user-0021/BLDC_MOTOR_DRIVER_ALPHA/README.md

# BLDC_MOTER_DRIVER_ALPHA
この回路は15~30Vほどの電源で回す三層モータードライバー向けの回路です
設計上の連続最大電流は10Aです(実験してないのでだめかも)
ヒートシンクとかで冷やしながらならFET的には35A行ける
## インターフェース
制御用のインターフェースはLVDSとなっております。
## 機能
ゲートドライバーに過電圧過電流などの保護があります  
ホールセンサの入力はアナログ入力になっているのでプログラムを書けばどのセンサタイプでも  
いけるはず
