user-0021/BLDC_MOTOR_DRIVER_ALPHA/BLDC_MOTOR_DRIVER_ALPHA.kicad_pcb

## KiCad design BLDC_MOTOR_DRIVER_ALPHA.kicad_pcb (2025-11-21)

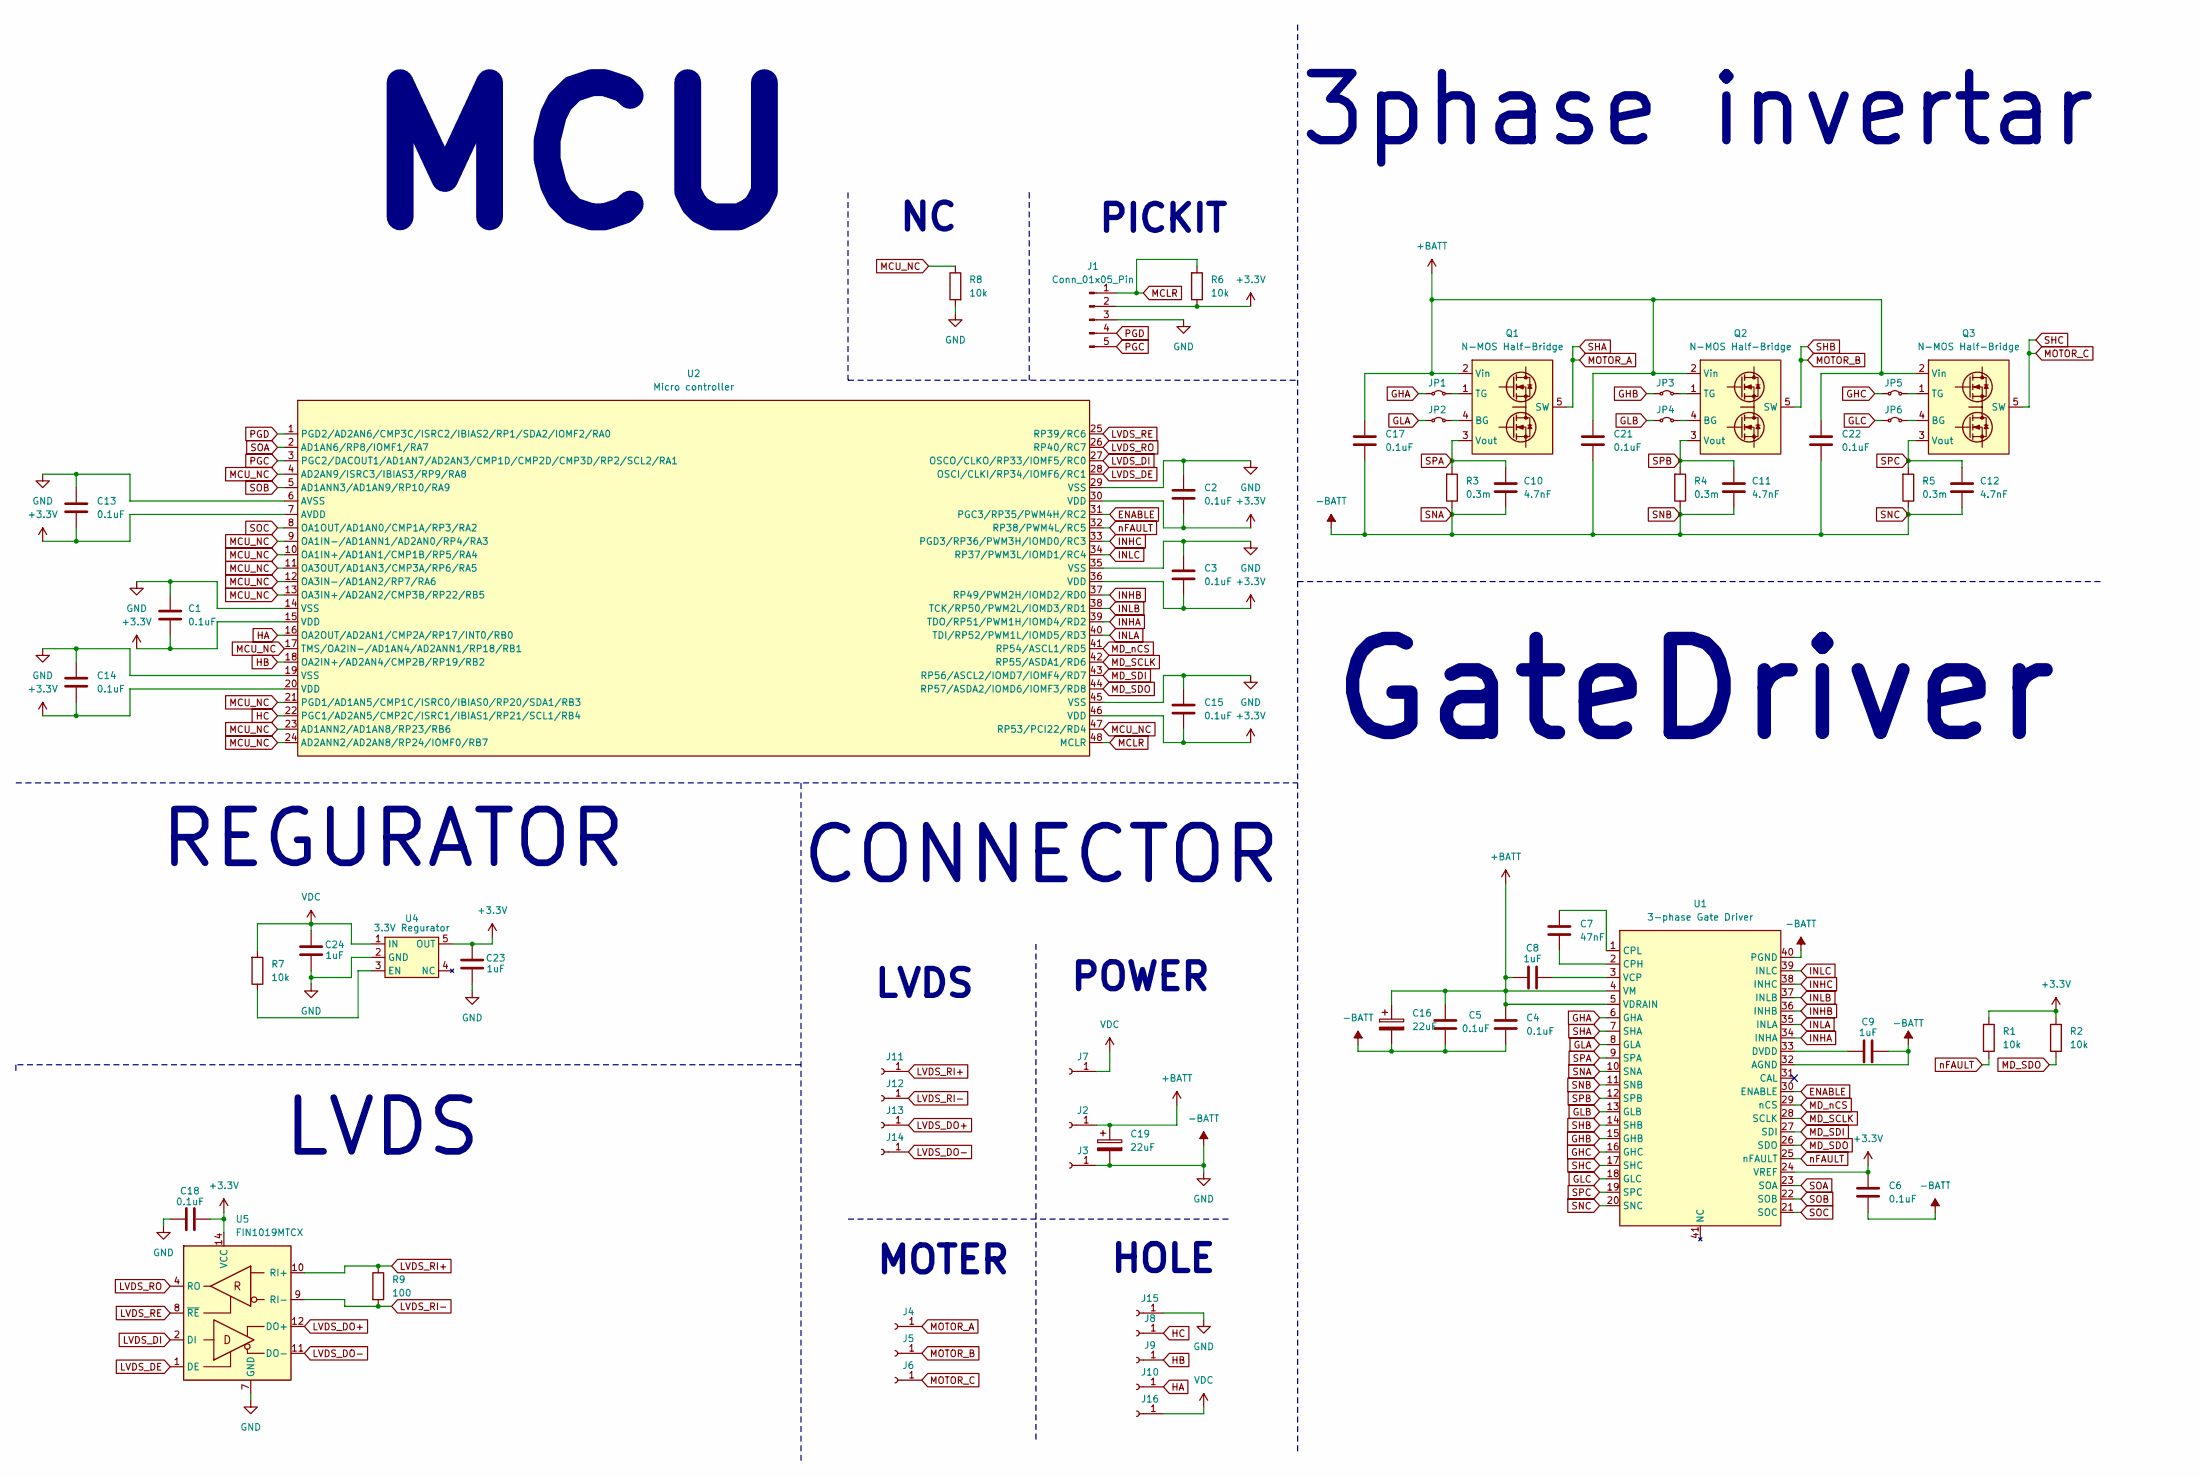
[picture p1: schematic BLDC_MOTOR_DRIVER_ALPHA.kicad_sch]

Parts:
C1, C2, C3, C4, C5, C6, C13, C14, C15, C17, C18, C21, C22: 0.1uF; C_0603_1608Metric; digikey none
C7: 47nF; C_0402_1005Metric; digikey 445-6897-1-ND
C8, C9, C23, C24: 1uF; C_0805_2012Metric; digikey 1276-1029-1-ND
C10, C11, C12: 4.7nF; C_0603_1608Metric; digikey 311-1083-1-ND
C16, C19: 22uF; CP_Elec_5x5.3; digikey 732-8505-1-ND
J1: Conn_01x05_Pin; PinHeader_1x05_P2.54mm_Vertical
J2, J3, J4, J5, J6: Conn_01x01_Socket; SolderWirePad_1x01_SMD_3x6mm
J7, J8, J9, J10, J11, J12, J13, J14, J15, J16: Conn_01x01_Socket; SolderWirePad_1x01_SMD_2x4mm
JP1, JP2, JP3, JP4, JP5, JP6: Jumper_2_Small_Bridged; R_0402_1005Metric
Q1, Q2, Q3: N-MOS Half-Bridge; CSD87588N; digikey 296-35792-1-ND
R1, R2, R6, R7, R8: 10k; R_0603_1608Metric; digikey 4988-NRC06F1002TRFCT-ND
R3, R4, R5: 0.3m; R_2512_6332Metric; digikey 738-CSNL2512FTL300CT-ND
R9: 100; R_0402_1005Metric; digikey 2019-RK73H1ETTP1000FCT-ND
U1: 3-phase Gate Driver; TB67Z833SFTG; digikey 264-TB67Z833SFTG(O,EL)CT-ND
U2: Micro controller; TQFP-48_7x7mm_P0.5mm; digikey 150-DSPIC33AK32MC105-I/PT-ND
U4: 3.3V Regurator; SOT-23-5; digikey 296-TLV74033PDBVRCT-ND
U5: FIN1019MTCX; TSSOP-14_4.4x5mm_P0.65mm; digikey FIN1019MTCXCT-ND

Connections:
+3.3V: C1.2, C2.2, C3.2, C6.1, C13.2, C14.2, C15.2, C18.1, C23.1, J1.2, R1.1, R2.1, R6.2, U1.24 (VREF), U2.7 (AVDD), U2.15 (VDD), U2.20 (VDD), U2.30 (VDD), U2.36 (VDD), U2.46 (VDD), U4.5 (OUT), U5.14 (VCC)
+BATT: C4.1, C5.2, C8.1, C16.1, C17.1, C19.1, C21.1, C22.1, J2.1, Q1.2 (Vin), Q2.2 (Vin), Q3.2 (Vin), U1.4 (VM), U1.5 (VDRAIN)
ENABLE: U1.30 (ENABLE), U2.31 (PGC3/RP35/PWM4H/RC2)
GHA: JP1.1 (A), U1.6 (GHA)
GHB: JP3.1 (A), U1.15 (GHB)
GHC: JP5.1 (A), U1.16 (GHC)
GLA: JP2.1 (A), U1.8 (GLA)
GLB: JP4.1 (A), U1.13 (GLB)
GLC: JP6.1 (A), U1.18 (GLC)
HA: J10.1, U2.16 (OA2OUT/AD2AN1/CMP2A/RP17/INT0/RB0)
HB: J9.1, U2.18 (OA2IN+/AD2AN4/CMP2B/RP19/RB2)
HC: J8.1, U2.22 (PGC1/AD2AN5/CMP2C/ISRC1/IBIAS1/RP21/SCL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)
INHA: U1.34 (INHA), U2.39 (TDO/RP51/PWM1H/IOMD4/RD2)
INHB: U1.36 (INHB), U2.37 (RP49/PWM2H/IOMD2/RD0)
INHC: U1.38 (INHC), U2.33 (PGD3/RP36/PWM3H/IOMD0/RC3)
INLA: U1.35 (INLA), U2.40 (TDI/RP52/PWM1L/IOMD5/RD3)
INLB: U1.37 (INLB), U2.38 (TCK/RP50/PWM2L/IOMD3/RD1)
INLC: U1.39 (INLC), U2.34 (RP37/PWM3L/IOMD1/RC4)
LVDS_DE: U2.28 (OSCI/CLKI/RP34/IOMF6/RC1), U5.1 (DE)
LVDS_DI: U2.27 (OSCO/CLKO/RP33/IOMF5/RC0), U5.2 (DI)
LVDS_DO+: J13.1, U5.12 (DO+)
LVDS_DO-: J14.1, U5.11 (DO-)
LVDS_RE: U2.25 (RP39/RC6), U5.8 (~RE)
LVDS_RI+: J11.1, R9.1, U5.10 (RI+)
LVDS_RI-: J12.1, R9.2, U5.9 (RI-)
LVDS_RO: U2.26 (RP40/RC7), U5.4 (RO)
MCLR: J1.1, R6.1, U2.48 (MCLR)
MCU_NC: R8.2, U2.4 (AD2AN9/ISRC3/IBIAS3/RP9/RA8), U2.9 (OA1IN-/AD1ANN1/AD2AN0/RP4/RA3), U2.10 (OA1IN+/AD1AN1/CMP1B/RP5/RA4), U2.11 (OA3OUT/AD1AN3/CMP3A/RP6/RA5), U2.12 (OA3IN-/AD1AN2/RP7/RA6), U2.13 (OA3IN+/AD2AN2/CMP3B/RP22/RB5), U2.17 (TMS/OA2IN-/AD1AN4/AD2ANN1/RP18/RB1), U2.21 (PGD1/AD1AN5/CMP1C/ISRC0/IBIAS0/RP20/SDA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), U2.23 (AD1ANN2/AD1AN8/RP23/RB6), U2.24 (AD2ANN2/AD2AN8/RP24/IOMF0/RB7), U2.47 (RP53/PCI22/RD4)
MD_SCLK: U1.28 (SCLK), U2.42 (RP55/ASDA1/RD6)
MD_SDI: U1.27 (SDI), U2.43 (RP56/ASCL2/IOMD7/IOMF4/RD7)
MD_SDO: R2.2, U1.26 (SDO), U2.44 (RP57/ASDA2/IOMD6/IOMF3/RD8)
MD_nCS: U1.29 (nCS), U2.41 (RP54/ASCL1/RD5)
MOTOR_A: J4.1, Q1.5 (SW), U1.7 (SHA)
MOTOR_B: J5.1, Q2.5 (SW), U1.14 (SHB)
MOTOR_C: J6.1, Q3.5 (SW), U1.17 (SHC)
unnamed: JP1.2 (B), Q1.1 (TG)
unnamed: JP2.2 (B), Q1.4 (BG)
unnamed: JP3.2 (B), Q2.1 (TG)
unnamed: JP4.2 (B), Q2.4 (BG)
unnamed: JP5.2 (B), Q3.1 (TG)
unnamed: JP6.2 (B), Q3.4 (BG)
unnamed: C7.2, U1.2 (CPH)
unnamed: C7.1, U1.1 (CPL)
unnamed: C9.1, U1.33 (DVDD)
unnamed: C8.2, U1.3 (VCP)
unnamed: R7.2, U4.3 (EN)
PGC: J1.5, U2.3 (PGC2/DACOUT1/AD1AN7/AD2AN3/CMP1D/CMP2D/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)
PGD: J1.4, U2.1 (PGD2/AD2AN6/CMP3C/ISRC2/IBIAS2/RP1/SDA2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)
SNA: C1.1, C2.1, C3.1, C4.2, C5.1, C6.2, C9.2, C10.2, C11.2, C12.2, C13.1, C14.1, C15.1, C16.2, C17.2, C18.2, C19.2, C21.2, C22.2, C23.2, C24.2, J1.3, J3.1, J15.1, R3.2, R4.2, R5.2, R8.1, U1.10 (SNA), U1.11 (SNB), U1.20 (SNC), U1.32 (AGND), U1.40 (PGND), U2.6 (AVSS), U2.14 (VSS), U2.19 (VSS), U2.29 (VSS), U2.35 (VSS), U2.45 (VSS), U4.2 (GND), U5.7 (GND)
SOA: U1.23 (SOA), U2.2 (AD1AN6/RP8/IOMF1/RA7)
SOB: U1.22 (SOB), U2.5 (AD1ANN3/AD1AN9/RP10/RA9)
SOC: U1.21 (SOC), U2.8 (OA1OUT/AD1AN0/CMP1A/RP3/RA2)
SPA: C10.1, Q1.3 (Vout), R3.1, U1.9 (SPA)
SPB: C11.1, Q2.3 (Vout), R4.1, U1.12 (SPB)
SPC: C12.1, Q3.3 (Vout), R5.1, U1.19 (SPC)
VDC: C24.1, J7.1, J16.1, R7.1, U4.1 (IN)
nFAULT: R1.2, U1.25 (nFAULT), U2.32 (RP38/PWM4L/RC5)

Notes on the sheet:
GateDriver
HOLE
PICKIT
CONNECTOR
3phase invertar
MOTER
LVDS
MCU
REGURATOR
POWER

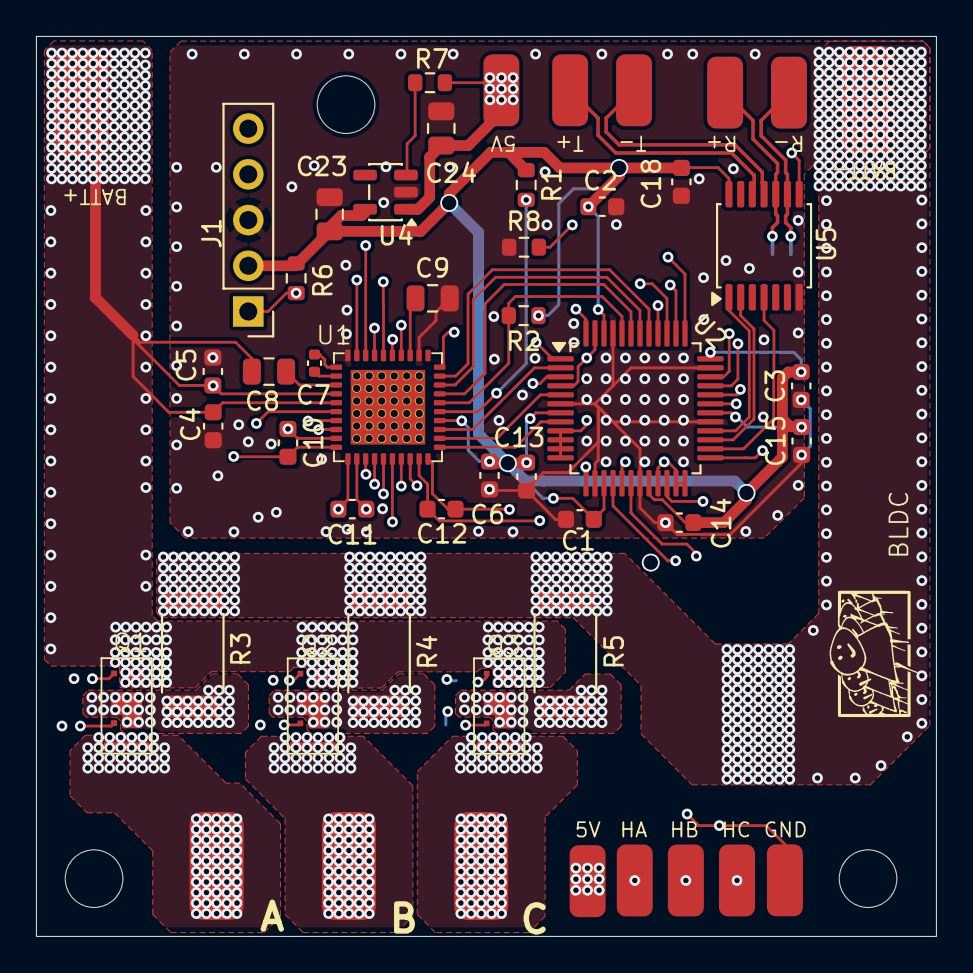
[picture p2: board BLDC_MOTOR_DRIVER_ALPHA.kicad_pcb from above]

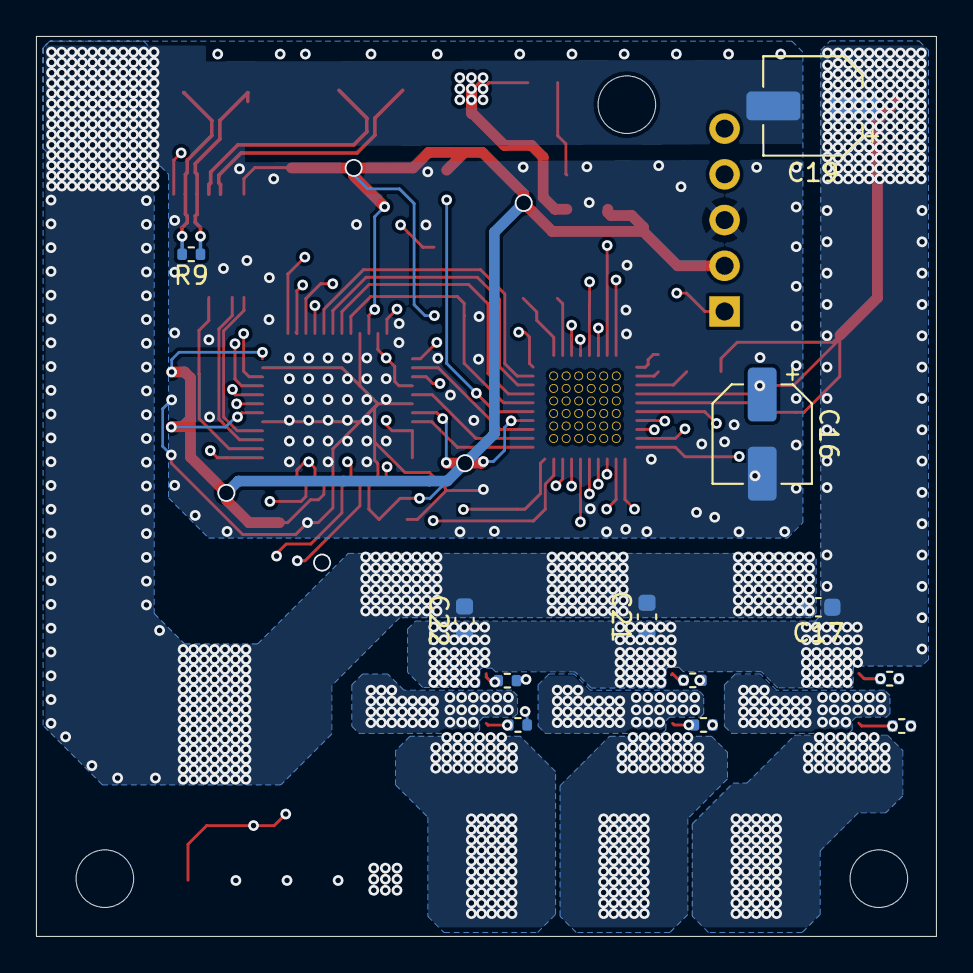
[picture p3: board BLDC_MOTOR_DRIVER_ALPHA.kicad_pcb from below]

Board: 8 copper layers, 50.0 x 50.0 mm, 61 parts (12 on the bottom side), 57 nets.
